iaroshukandrii/arduino-race-chrono-oil-temp-sensor/IMG_4663.JPG

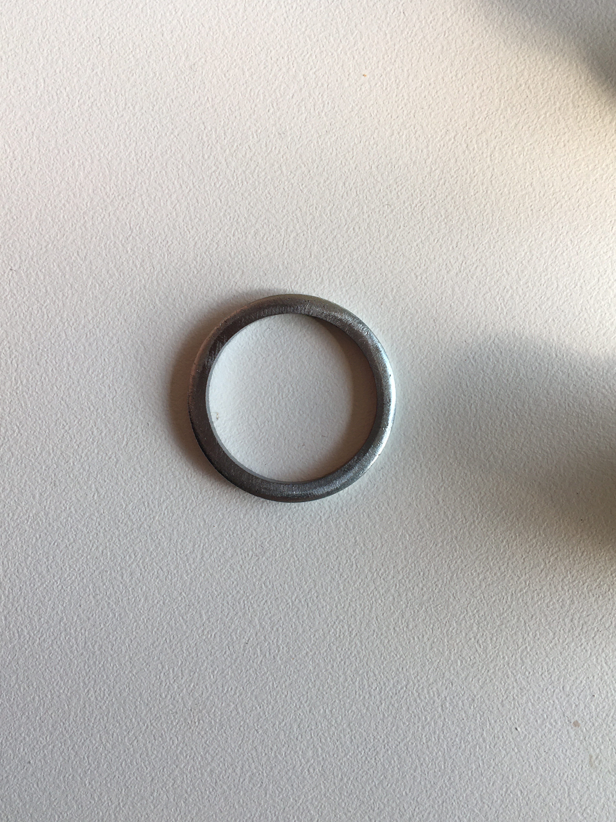
[picture p4: IMG_4663.JPG]
IMG_4663.JPG
